ayourk/z80-retro-i2cspi/kicad/i2c-adapter-pcb.png

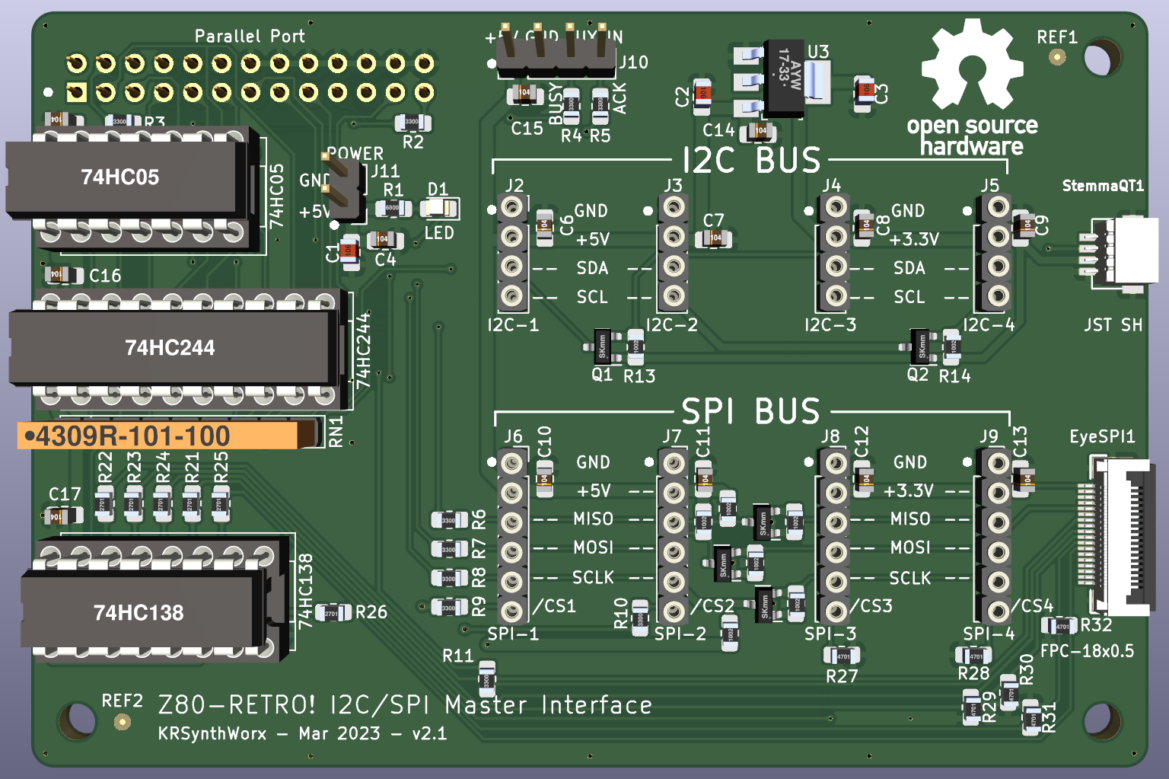
kicad/i2c-adapter-pcb.png
