ayourk/z80-retro-i2cspi/kicad/i2c-adapter-schematic.pdf

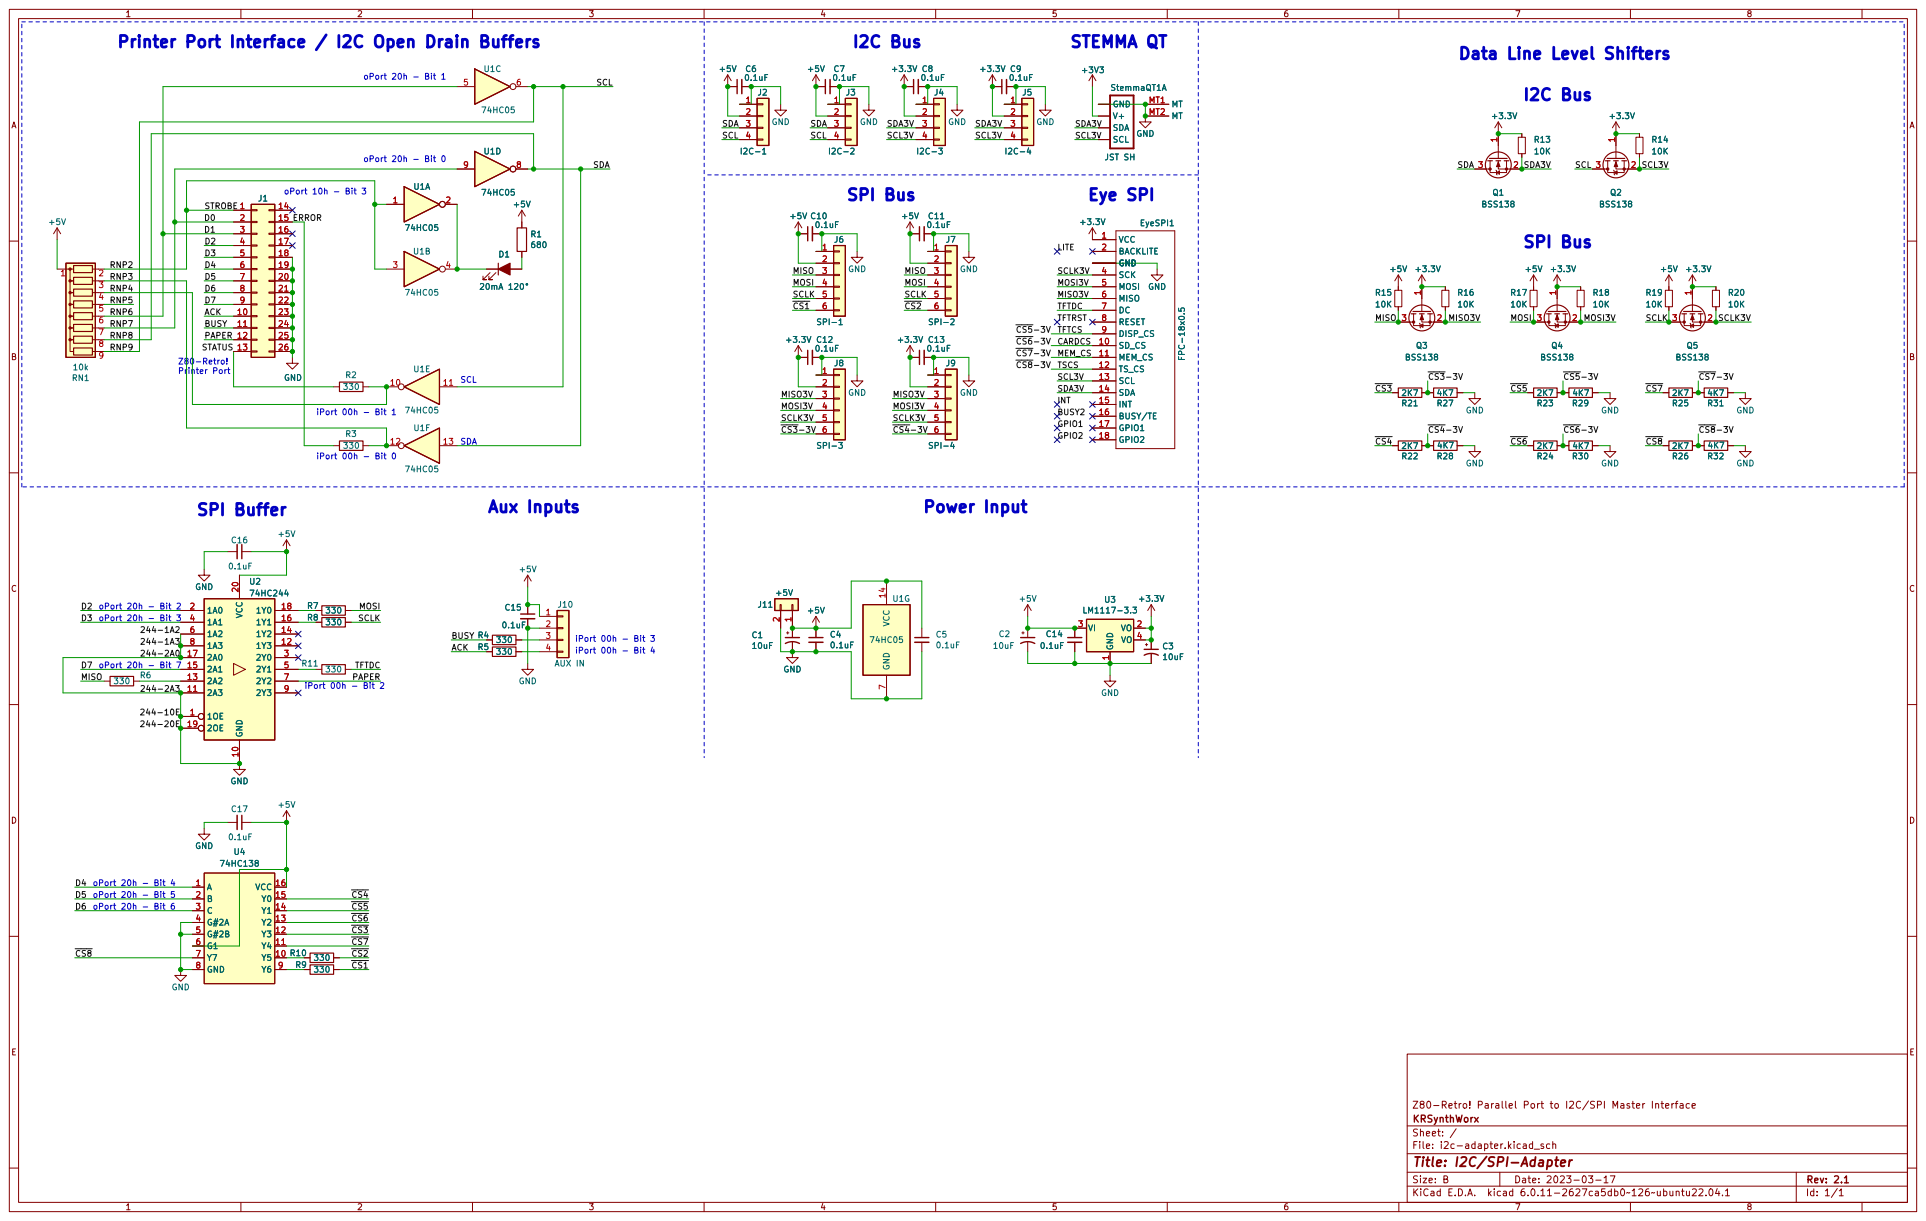
[picture p2: page 1]

Eye SPI oPort 20h - Bit 2

2 2 | | 15 15
3 3 | | 16 16
4 4 | | 17 17
