ayourk/z80-retro-i2cspi/kicad/i2c-adapter.kicad_pcb

## KiCad design kicad/i2c-adapter.kicad_pcb (2023-04-18)

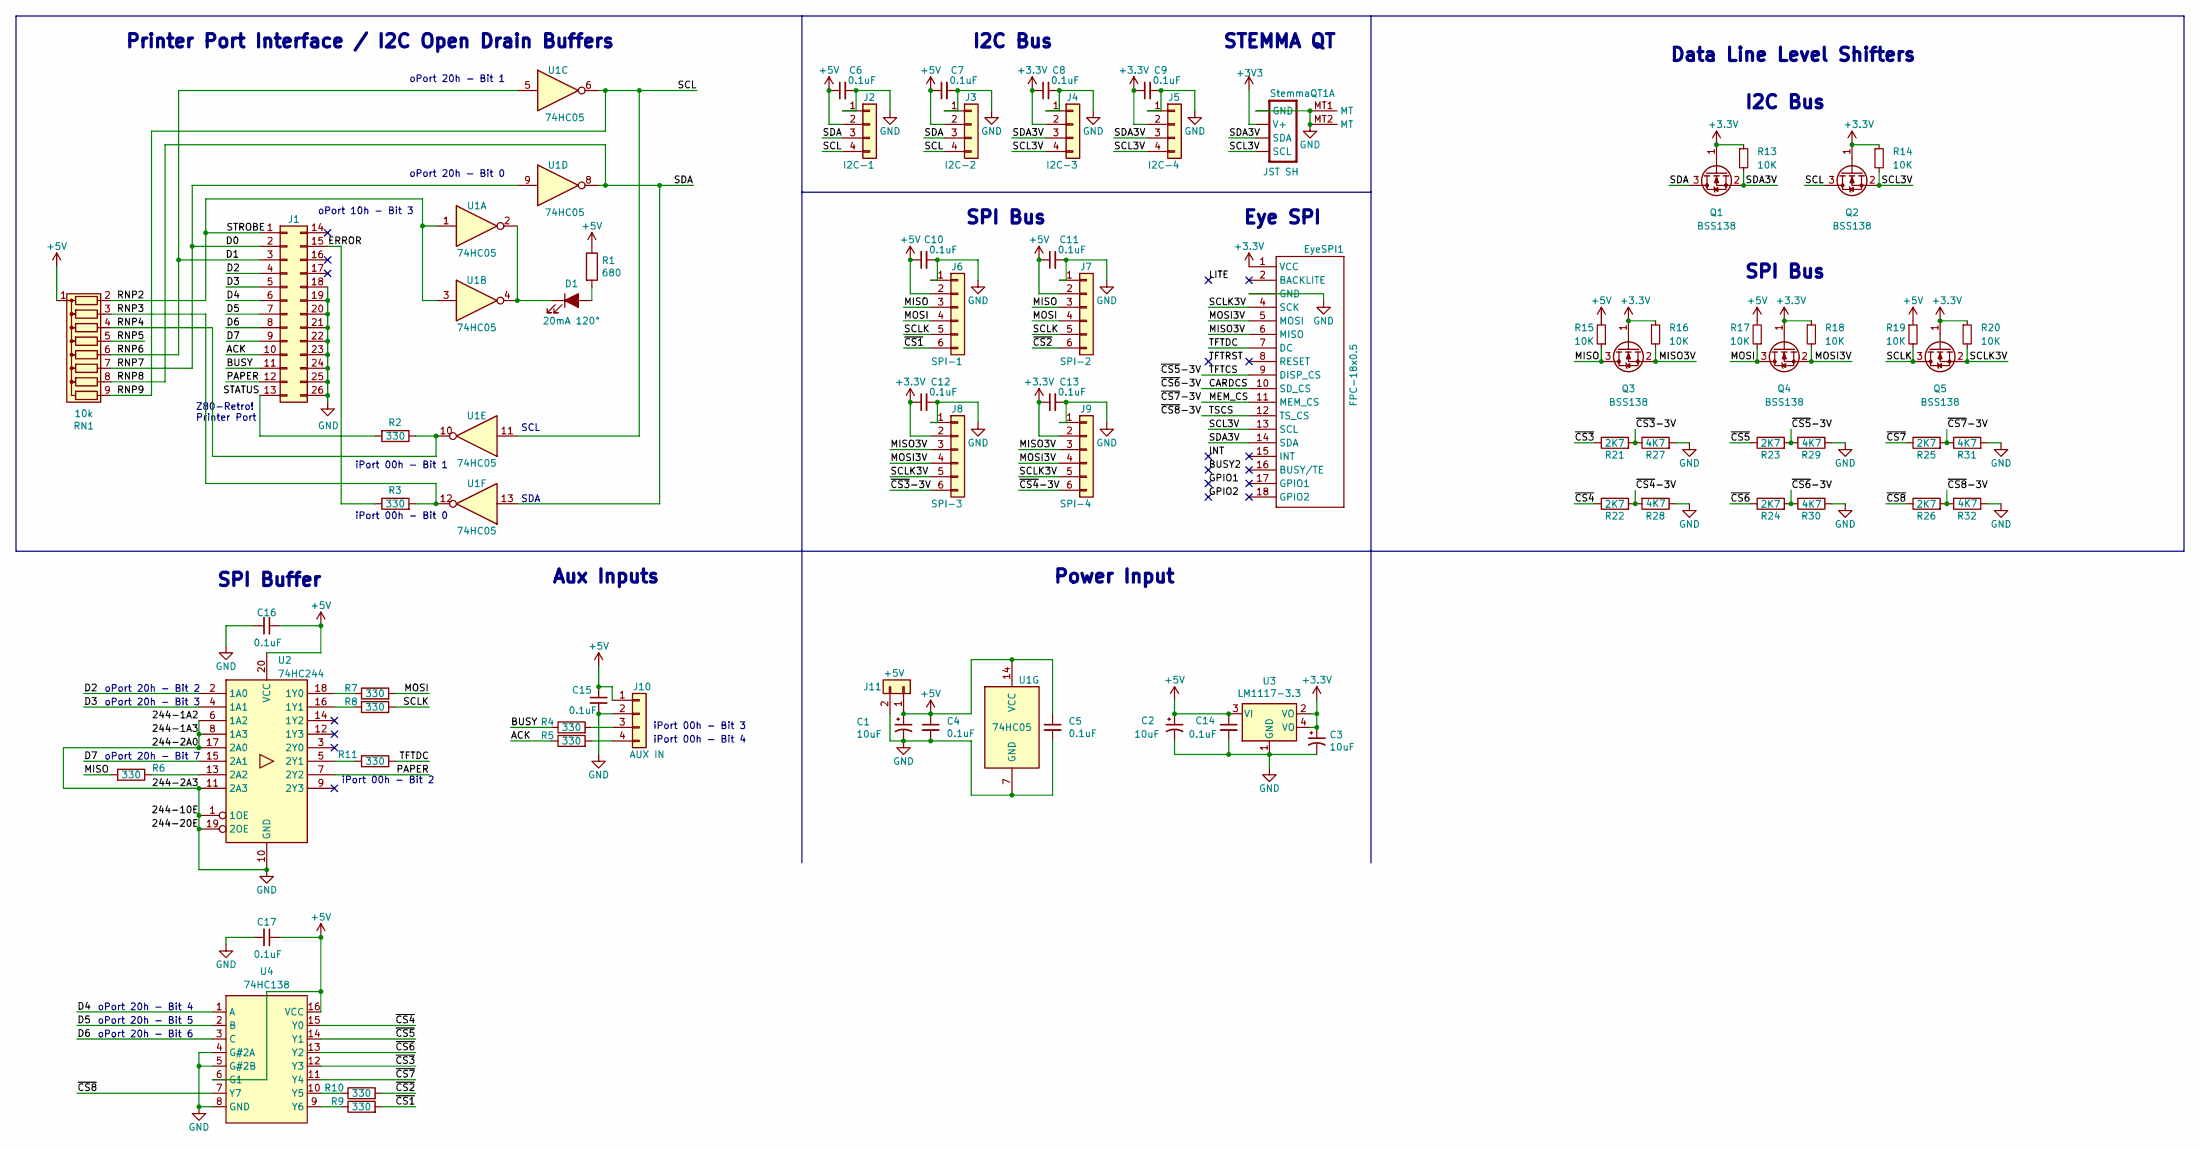
[picture p3: schematic i2c-adapter.kicad_sch, I2C/SPI-Adapter]

Parts:
C1: 10uF; C_0805_2012Metric_Pad1.18x1.45mm_HandSolder; MPN CL21B106KOQNNNE; LCSC C95841
C2, C3: 10uF; C_0805_2012Metric_Pad1.18x1.45mm_HandSolder; MPN CL21B106KOQNNNE; Digi-Key_PN 1276-2872-1-ND
C4, C5, C6, C7, C8, C9, C10, C11, C12, C13, C15, C16, C17: 0.1uF; C_0805_2012Metric_Pad1.18x1.45mm_HandSolder; MPN CL21B104KBFNNNE; LCSC C136621
C14: 0.1uF; C_0805_2012Metric_Pad1.18x1.45mm_HandSolder; MPN CL21B104KBFNNNE; Digi-Key_PN 1276-1180-1-ND
D1: 20mA 120°; LED_0805_2012Metric_Pad1.15x1.40mm_HandSolder; MPN 0805YGBD008S01; LCSC C375546
EyeSPI1: FPC-18x0.5; EYE_SPI_DISPLAY_BOTCONTACT; MPN TF31-18S-0.5SH(800); LCSC C2856802
J1: Conn_02x13_Top_Bottom; PinSocket_2x13_P2.54mm_Vertical; MPN CES-113-02-T-D; Digi-Key_PN SAM15543-ND
J2: I2C-1; PinSocket_1x04_P2.54mm_Vertical; MPN SL-104-TT-19; Digi-Key_PN SAM15257-ND
J3: I2C-2; PinSocket_1x04_P2.54mm_Vertical; MPN SL-104-TT-19; Digi-Key_PN SAM15257-ND
J4: I2C-3; PinSocket_1x04_P2.54mm_Vertical; MPN SL-104-TT-19; Digi-Key_PN SAM15257-ND
J5: I2C-4; PinSocket_1x04_P2.54mm_Vertical; MPN SL-104-TT-19; Digi-Key_PN SAM15257-ND
J6: SPI-1; PinSocket_1x06_P2.54mm_Vertical; MPN SL-106-TT-19; Digi-Key_PN SL-106-TT-19-ND
J7: SPI-2; PinSocket_1x06_P2.54mm_Vertical; MPN SL-106-TT-19; Digi-Key_PN SL-106-TT-19-ND
J8: SPI-3; PinSocket_1x06_P2.54mm_Vertical; MPN SL-106-TT-19; Digi-Key_PN SL-106-TT-19-ND
J9: SPI-4; PinSocket_1x06_P2.54mm_Vertical; MPN SL-106-TT-19; Digi-Key_PN SL-106-TT-19-ND
J10: AUX IN; PinHeader_1x04_P2.54mm_Vertical; MPN TSW-104-07-T-S; Digi-Key_PN SAM1035-04-ND
J11: +5V; PinHeader_1x02_P2.54mm_Vertical; MPN TSW-102-07-T-S; Digi-Key_PN SAM1035-02-ND
Q1, Q2, Q3, Q4, Q5: BSS138; SOT-23; MPN BSS138K; LCSC C255592
R1: 680; R_0805_2012Metric_Pad1.20x1.40mm_HandSolder; MPN ERJ-6ENF6800V; LCSC C410034
R2, R3, R4, R5, R6, R7, R8, R9, R10, R11: 330; R_0805_2012Metric_Pad1.20x1.40mm_HandSolder; MPN ERJ-6ENF3300V; LCSC C410007
R13, R14, R15, R16, R17, R18, R19, R20: 10K; R_0805_2012Metric_Pad1.20x1.40mm_HandSolder; MPN ERJ-6ENF1002V; Digi-Key_PN P10.0KCCT-ND
R21, R22, R23, R24, R25, R26: 2K7; R_0805_2012Metric_Pad1.20x1.40mm_HandSolder; MPN ERJ-6ENF2701V; LCSC C409999
R27, R28, R29, R30, R31, R32: 4K7; R_0805_2012Metric_Pad1.20x1.40mm_HandSolder; MPN ERJ-6ENF4701V; LCSC C192064
RN1: 10k; R_Array_SIP9; MPN 4309R-101-100LF; Digi-Key_PN 118-4309R-101-100LF-ND
StemmaQT1: JST SH; JST_SH4; MPN SM04B-SRSS-TB(LF)(SN); LCSC C2764183
U1: 74HC05; DIP-14_W7.62mm_Socket; MPN SN74HC05N; Digi-Key_PN 296-1568-5-ND
U2: 74HC244; DIP-20_W7.62mm_Socket; MPN SN74HC244N; Digi-Key_PN 296-1582-5-ND
U3: LM1117-3.3; SOT-223; MPN NCP1117ST33T3G; Digi-Key_PN NCP1117ST33T3GOSCT-ND
U4: 74HC138; DIP-16_W7.62mm_Socket; MPN SN74HC138N; Digi-Key_PN 296-1575-5-ND

Connections:
+5V: C1.1, C2.1, C4.1, C5.1, C6.1, C7.1, C10.1, C11.1, C14.1, C15.1, C16.1, C17.1, J2.2, J3.2, J6.2, J7.2, J10.1, J11.1, R1.1, R15.2, R17.2, R19.1, RN1.1 (common), U1.14 (VCC), U2.20 (VCC), U3.3 (VI), U4.6 (G1), U4.16 (VCC)
/ACK: J1.10, R5.1
/BUSY: J1.11, R4.1
/CARDCS: EyeSPI1.10 (SD_CS), R24.2, R30.2
/D0: J1.2, RN1.7 (R6), U1.9
/D1: J1.3, RN1.6 (R5), U1.5
/D2: J1.4, U2.2 (1A0)
/D3: J1.5, U2.4 (1A1)
/D4: J1.6, U4.1 (A)
/D5: J1.7, U4.2 (B)
/D6: J1.8, U4.3 (C)
/D7: J1.9, U2.15 (2A1)
/ERROR: J1.15, R3.1
/MEM_CS: EyeSPI1.11 (MEM_CS), R25.2, R31.1
/MISO: J6.3, J7.3, Q3.3 (D), R6.2, R15.1
/MISO3V: EyeSPI1.6 (MISO), J8.3, J9.3, Q3.2 (S), R16.2
/MOSI: J6.4, J7.4, Q4.3 (D), R7.2, R17.1
/MOSI3V: EyeSPI1.5 (MOSI), J8.4, J9.4, Q4.2 (S), R18.2
/PAPER: J1.12, U2.7 (2Y2)
/RNP2: J1.1, RN1.2 (R1), U1.1, U1.3
/RNP3: R3.2, RN1.3 (R2), U1.12
/RNP4: R2.1, RN1.4 (R3), U1.10
/RNP5: RN1.5 (R4)
/RNP8: J2.3, J3.3, Q1.3 (D), RN1.8 (R7), U1.8, U1.13
/RNP9: J2.4, J3.4, Q2.3 (D), RN1.9 (R8), U1.6, U1.11
/SCL3V: EyeSPI1.13 (SCL), J4.4, J5.4, Q2.2 (S), R14.2, StemmaQT1.4 (SCL)
/SCLK: J6.5, J7.5, Q5.3 (D), R8.2, R19.2
/SCLK3V: EyeSPI1.4 (SCK), J8.5, J9.5, Q5.2 (S), R20.2
/SDA3V: EyeSPI1.14 (SDA), J4.3, J5.3, Q1.2 (S), R13.2, StemmaQT1.3 (SDA)
/STATUS: J1.13, R2.2
/TFTCS: EyeSPI1.9 (DISP_CS), R23.2, R29.2
/TFTDC: EyeSPI1.7 (DC), R11.1
/TSCS: EyeSPI1.12 (TS_CS), R26.2, R32.2
/~CS1: J6.6, R9.2
/~CS2: J7.6, R10.2
/~CS3: R21.1, U4.12 (Y3)
/~CS3-3V: J8.6, R21.2, R27.1
/~CS4: R22.1, U4.15 (Y0)
/~CS4-3V: J9.6, R22.2, R28.2
/~CS5: R23.1, U4.14 (Y1)
/~CS6: R24.1, U4.13 (Y2)
/~CS7: R25.1, U4.11 (Y4)
/~CS8: R26.1, U4.7 (Y7)
GND: C1.2, C2.2, C3.2, C4.2, C5.2, C6.2, C7.2, C8.2, C9.2, C10.2, C11.2, C12.2, C13.2, C14.2, C15.2, C16.2, C17.2, EyeSPI1.3 (GND), EyeSPI1.SUPPORT1 (GND), EyeSPI1.SUPPORT2 (GND), J1.18, J1.19, J1.20, J1.21, J1.22, J1.23, J1.24, J1.25, J1.26, J2.1, J3.1, J4.1, J5.1, J6.1, J7.1, J8.1, J9.1, J10.2, J11.2, R27.2, R28.1, R29.1, R30.1, R31.2, R32.1, StemmaQT1.1 (GND), StemmaQT1.MT1 (MT), StemmaQT1.MT2 (MT), U1.7 (GND), U2.1 (1OE), U2.6 (1A2), U2.8 (1A3), U2.10 (GND), U2.11 (2A3), U2.17 (2A0), U2.19 (2OE), U3.1 (GND), U4.4 (G#2A), U4.5 (G#2B), U4.8 (GND)
unnamed: D1.1 (K), U1.2, U1.4
unnamed: D1.2 (A), R1.2
unnamed: J10.3, R4.2
unnamed: J10.4, R5.2
unnamed: R6.1, U2.13 (2A2)
unnamed: R7.1, U2.18 (1Y0)
unnamed: R8.1, U2.16 (1Y1)
unnamed: R9.1, U4.9 (Y6)
unnamed: R10.1, U4.10 (Y5)
unnamed: R11.2, U2.5 (2Y1)

Notes on the sheet:
iPort 00h - Bit 0
oPort 20h - Bit 3
oPort 20h - Bit 5
oPort 20h - Bit 1
Data Line Level Shifters
oPort 20h - Bit 0
oPort 10h - Bit 3
Printer Port Interface / I2C Open Drain Buffers
Z80-Retro! Printer Port
oPort 20h - Bit 2
oPort 20h - Bit 7
SPI Bus
oPort 20h - Bit 6
I2C Bus
oPort 20h - Bit 4
SCL
STEMMA QT
Power Input
Aux Inputs
iPort 00h - Bit 4
Eye SPI
iPort 00h - Bit 3
iPort 00h - Bit 2
SDA
SPI Buffer
iPort 00h - Bit 1

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
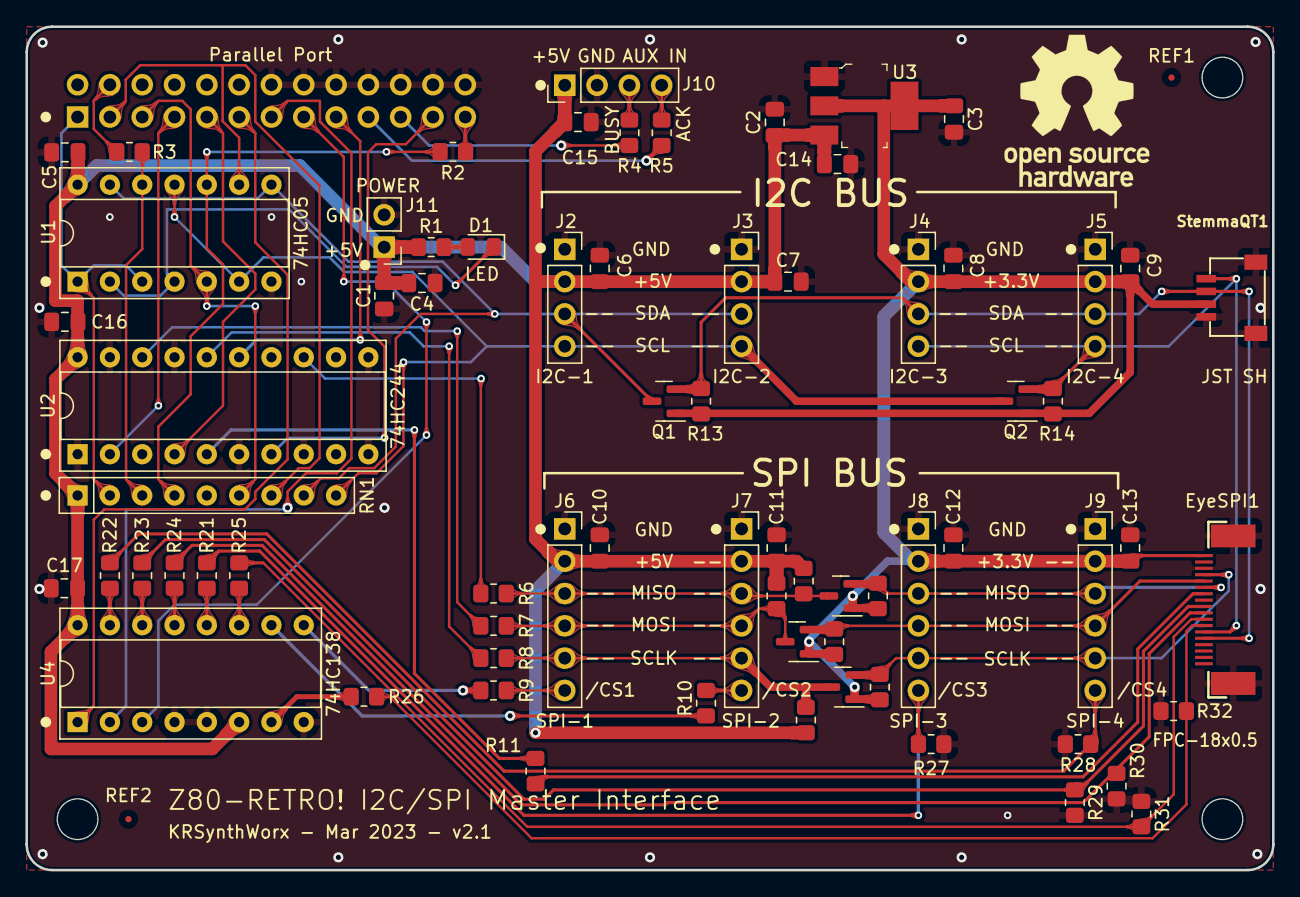
[picture p4: board i2c-adapter.kicad_pcb from above]

Board: 2 copper layers, 98.0 x 66.3 mm, 74 parts (1 on the bottom side), 54 nets.

Other parts of the board:
REF1, REF2: Fiducial_0.5mm_Mask1.5mm
