ayourk/z80-retro-i2cspi/(commit log)

2023-04-11 With the help of @K3130440, I've added level shifters to the 3V3 data lines and a 74HC138 which adds more Chip Select lines (that are then routed to the EyeSPI connector). Updated Schematic PDF to in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
    [i2c-adapter.kicad_pcb, i2c-adapter.kicad_sch]
2023-04-12 Updated BOM. Most parts are available from both LCSC and DigiKey. Added Teardrops to PCB.
    [i2c-adapter.kicad_pcb]
2023-04-18 Enhanced 3D Models and render; Moved away from Tantalum footprint.
    [i2c-adapter.kicad_pcb, i2c-adapter.kicad_sch]
